jfrohnhofen/hydra-nano/enclosure/enclosure_top_half.step

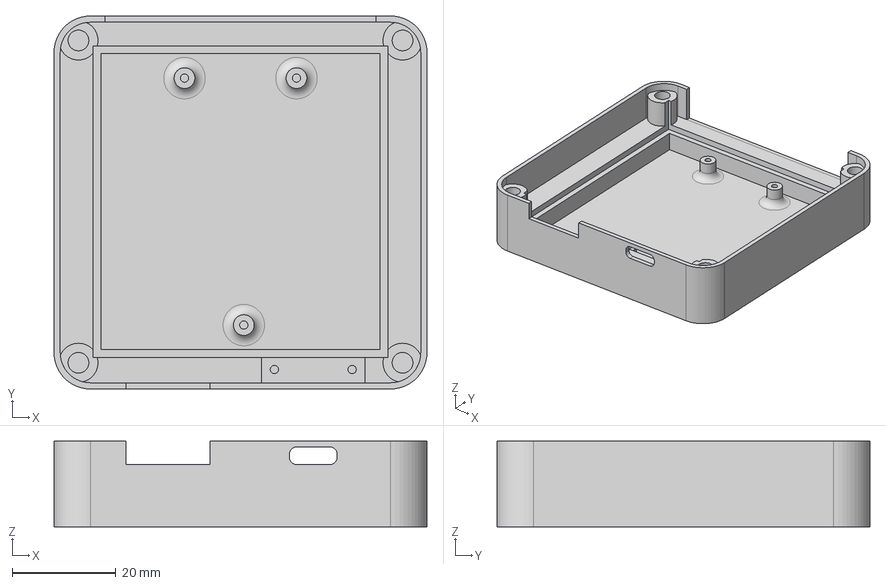
[picture p2: CAD file, 2026-11-10]
enclosure/enclosure_top_half.step
71.9 x 71.9 x 16.5 mm
