jfrohnhofen/hydra-nano/(list of files, cad)

Other CAD files:
enclosure/enclosure_bottom_half.step
