jfrohnhofen/hydra-nano/pcb/layouts/hydra-nano/hydra-nano.kicad_pcb

## KiCad design pcb/layouts/hydra-nano/hydra-nano.kicad_pcb (2026-11-10)

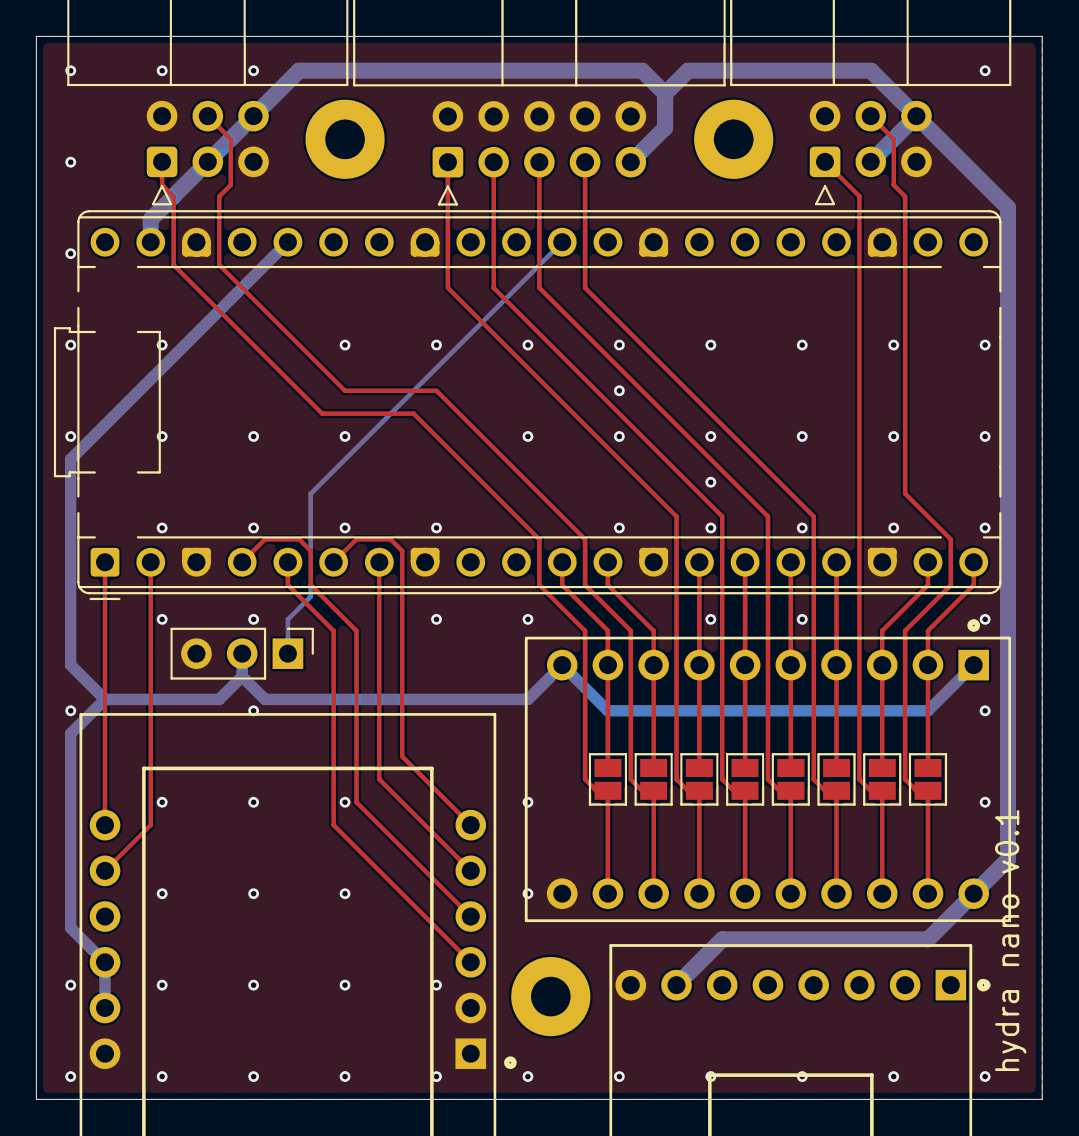
[picture p3: board hydra-nano.kicad_pcb from above]

Board: 2 copper layers, 55.9 x 59.1 mm, 19 parts (0 on the bottom side), 26 nets.

Parts:
U1: W5500_Module_2x06_P2.54mm_W20.32mm
U2: RaspberryPi_Pico_Common_THT
U3: USBC_Breakout_8Pin_20x14mm
U4, U5: IDC-Header_2x03_P2.54mm_Horizontal
U6: IDC-Header_2x05_P2.54mm_Horizontal
U7, U9, U10, U11, U12, U13, U14, U15: SolderJumper-2_P1.27mm_Open_Pad1.0x1.5mm
U8: Module_LevelShifter_2x10_P2.54mm_W12.7mm
U16: PinHeader_1x03_P2.54mm_Vertical
U17, U18, U19: MountingHole_2.2mm_M2_Pad

Connections:
GND: U1.1, U1.2, U1.7, U2.3, U2.8, U2.13, U2.18, U2.23, U2.28, U2.33, U2.38, U3.8, U4.2, U4.5, U5.2, U5.5, U6.2, U6.4, U6.6, U6.8, U6.10, U8.11, U16.3
MISO: U1.12, U2.1
MOSI: U1.3, U2.5
SCLK: U1.4, U2.4
a1: U2.20, U7.1, U8.2
a2: U2.19, U8.3, U9.1
a3: U2.17, U8.4, U10.1
a4: U2.16, U8.5, U11.1
a5: U2.15, U8.6, U12.1
a6: U2.14, U8.7, U13.1
a7: U2.12, U8.8, U14.1
a8: U2.11, U8.9, U15.1
b3: U6.7, U8.17, U10.2
b4: U6.5, U8.16, U11.2
b5: U6.3, U8.15, U12.2
b6: U6.1, U8.14, U13.2
footprint-gpio_a-0: U4.1, U8.18, U9.2
footprint-gpio_a-1: U5.1, U8.12, U15.2
footprint-gpio_b-0: U4.4, U7.2, U8.19
footprint-gpio_b-1: U5.4, U8.13, U14.2
gp1: U1.11, U2.2
gp4: U1.6, U2.6
gp5: U1.5, U2.7
power-VCC: U2.39, U3.7, U4.3, U4.6, U5.3, U5.6, U6.9, U8.20
power_3v3-VCC: U1.8, U1.9, U2.36, U8.1, U8.10, U16.2
rst: U2.30, U16.1
