jfrohnhofen/hydra-nano/firmware/app/src/rand.rs

//! Tiny non-cryptographic PRNG. The F411 has no hardware RNG, and the users
//! here (mDNS response jitter, network stack seed) don't need real entropy;
//! they just need different devices to behave differently, hence the seed
//! comes from the UID-derived identity.

use core::convert::Infallible;

use rand_core::TryRng;

/// xorshift64*.
pub struct Xorshift(u64);

impl Xorshift {
    pub fn new(seed: u64) -> Self {
        Self(if seed == 0 {
            0x9E37_79B9_7F4A_7C15
        } else {
            seed
        })
    }

    fn step(&mut self) -> u64 {
        let mut x = self.0;
        x ^= x >> 12;
        x ^= x << 25;
        x ^= x >> 27;
        self.0 = x;
        x.wrapping_mul(0x2545_F491_4F6C_DD1D)
    }
}

impl TryRng for Xorshift {
    type Error = Infallible;

    fn try_next_u32(&mut self) -> Result<u32, Infallible> {
        Ok((self.step() >> 32) as u32)
    }

    fn try_next_u64(&mut self) -> Result<u64, Infallible> {
        Ok(self.step())
    }

    fn try_fill_bytes(&mut self, dst: &mut [u8]) -> Result<(), Infallible> {
        for chunk in dst.chunks_mut(8) {
            let bytes = self.step().to_le_bytes();
            chunk.copy_from_slice(&bytes[..chunk.len()]);
        }
        Ok(())
    }
}
