jfrohnhofen/hydra-nano/(commit log)

2026-11-10 pcb v0.1
    [hydra-nano.kicad_pcb]
2026-11-10 enclosure and label gen script
    [enclosure_bottom_half.step, enclosure_top_half.step]
