jfrohnhofen/hydra-nano/(notices)

Notices in the files:
README.md:
License: MIT
